eludwig17/Magic-Millipede/updated_room_diagram.pdf

# 4 feet

# 4 feet

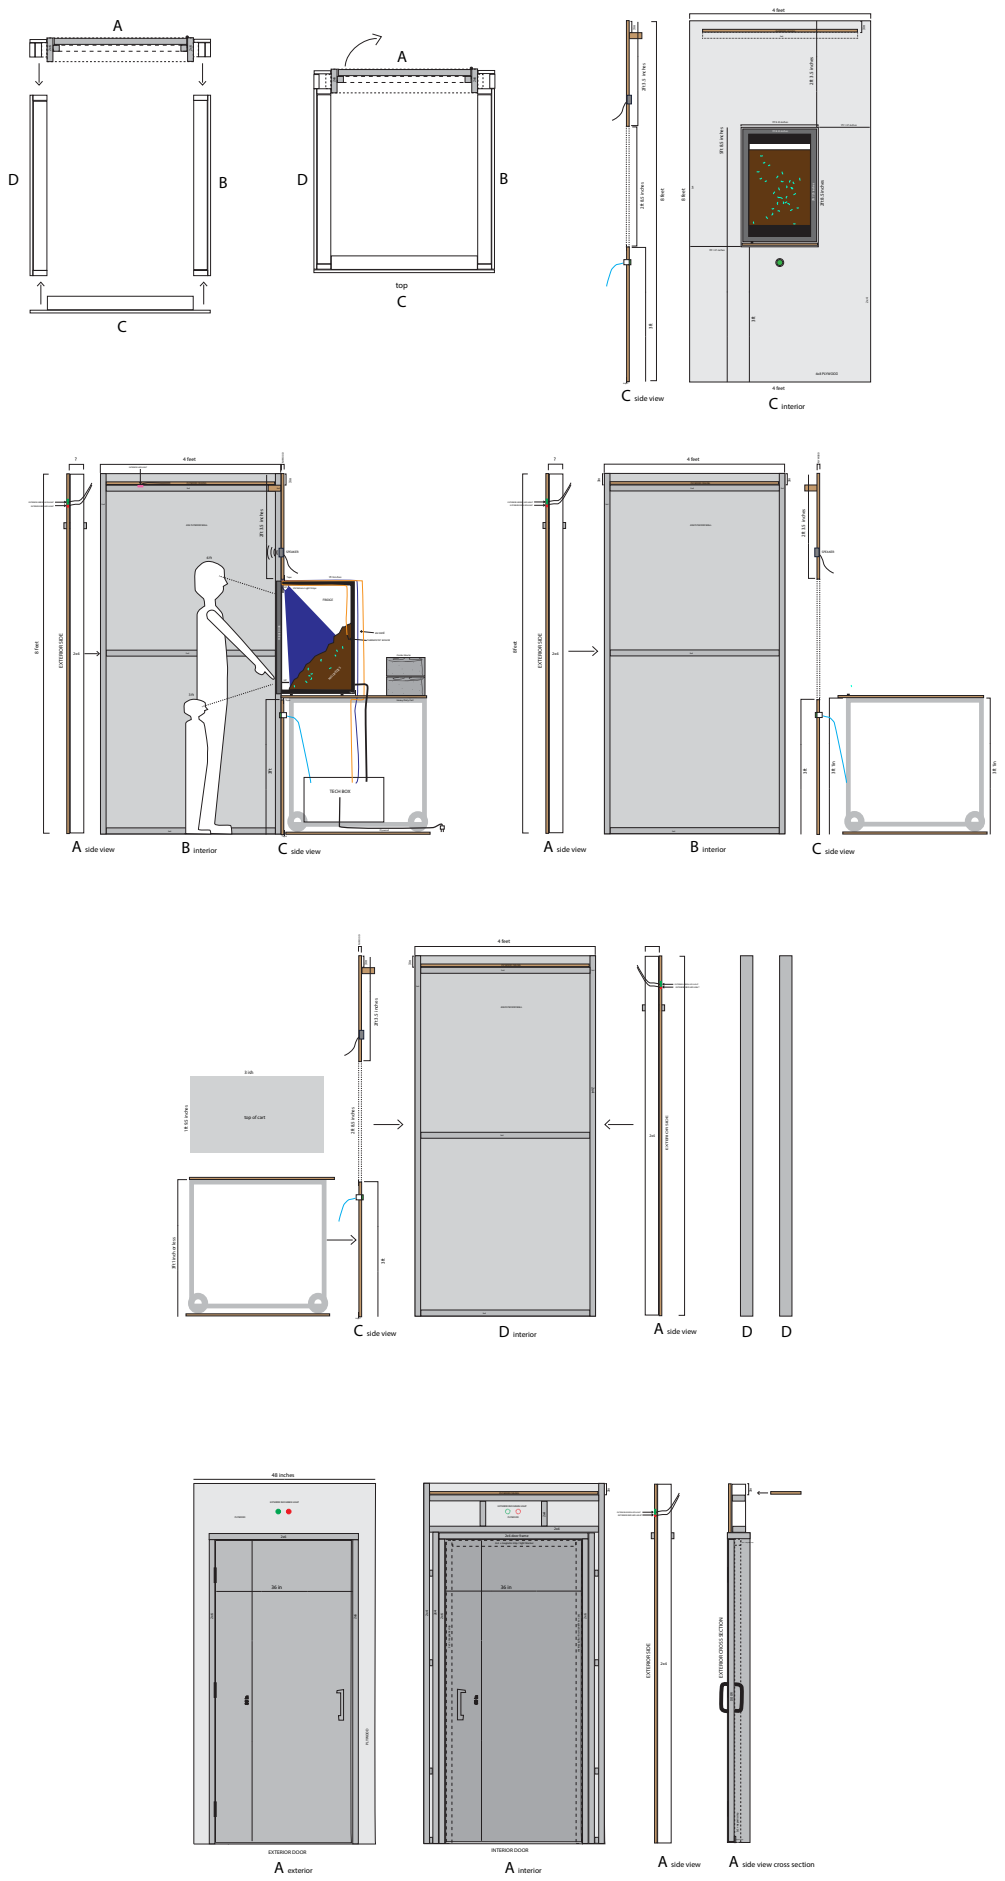
[picture p7: page 1]
EXTERIOR SIDE; TECH BOX; THERMOSTAT SENSOR; Tape; LIP; Cinder blocks; Plywood; uv cord; FRIDGE; SPEAKER; Glass Window; MILLIPEDES; 4 feet; 8 feet; 2ft 8.5 inches; 1ft 9.5 inches; 3ft 1inch or less; 3 ish; 5ft 8.5 inches; 2ft 3.5 inches; 1ft 8.25 inches; 1ft 9.25 inches; 1ft 9 inches; 1ft 1.37 inches; 2ft 7.25 inches; PLYWOOD; PLYWOOD CEILING; 4X8 PLYWOOD WALL; 4x8 PLYWOOD; FRIDGE DOOR; 2ft 3.5 inches 3ft; 48 inches; 96 inches; 2x2 + magnetic strip; 2x6 door frame; EXTERIOR DOOR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

INTERIOR LED LIGHT

EXTERIOR GREEN LED LIGHT
EXTERIOR RED LED LIGHT

UV 365nm Light Strips

Heavy Duty Cart

top of cart

EXTERIOR RED GREEN LIGHT

2x2 + magnetic strip / light blocker

EXTERIOR CROSS SECTION

light sweep ²x2 + magnetic strip
