eludwig17/Magic-Millipede/documentation/Maintenance, Care, Troubleshooting Guide.pdf

# Magic Millipedes Exhibit

## Maintenance, Care, and Troubleshooting Guide

This guide is intended to be used by museum staff who will handle operations and care in the millipede exhibit daily. This guide explains how the exhibit works, safety hazards that need to be aware of and what routine maintenance to ensure systems are running smoothly and correctly. This document requires no engineering background to follow the procedures outlined in the document; however, it’s necessary to read the safety part of this document before performing any task that will require opening up the tech box and/or accessing the UV light strip that is inside the millipede habitat.

# 1. System Overview

The millipedarium is a 16 x 12 x 8 ft enclosed structure that holds 4 identical visitor rooms that are along the back wall, with each room being fully independent of each other; each has its own habitat, electronics, and presentation system. As a result of this design, one room will not affect the other rooms

## Room Components

- A UV (365 nm) LED strip, which is mounted on the inside of the habitat, which will make the millipedes glow, which is switched on and off by a power relay module.
- A glass-fronted refrigerated habitat, which holds the live Motyxia millipedes; the fridge keeps the habitat at the optimal environment and is run on its own dedicated power circuit; the tech box has no control over the fridge.
- An interior speaker, which will play the 2-minute educational narration and music
- A red interior light, which is mounted in the top of the room; the light is always set to on to provide low-level ambient lighting, allowing visitors to see just enough of the inside of the room. The only time the interior red light is set to off is after the first 30 seconds of the narration.
- LED push button, which is mounted below the glass, which allows the visitor to start the 2-minute presentation.
- An exterior red and green indicator light, which tells other visitors outside whether or not the room is available (green light) or in use (red light)
- Tech Box, which is mounted out of the visitors' reach inside the millipedarium, where only staff can access. The small enclosure contains the microcontroller, audio sound board, amplifier, and relay module. It is powered by the 12V power supply plugged into a commercial surge protector.

## How a Visit Works

When the tech box is powered on, the exterior light above the door on the outside is green. When a visitor enters the exhibit, the visitor may faintly see the millipedes under the interior red light, and will press the button to start the presentation. Once pressed, the exterior light switches to red and will stay red for the 2-minute duration; the presentation will run through 3 phases in the code automatically.

IDLE | Awaits Button Press | Interior Red light & Exterior green Light on
PHASE 1 | 0:00-0:30 | Audio narration track 1 begins, UV light is off, interior red light is turned off at
0:30
PHASE 2 | 0:30-1:30 | UV light turns on, audio narration track 2 begins,
PHASE 3 | 1:30-2:00 | UV light turns off, audio track 3 - music plays for last 30 seconds
END | 2:00 | Code returns back to IDLE state; room is set back to default configuration & awaits next
visitor

Note: When a presentation is running, the button inputs are ignored entirely, thus ensuring pressing it repeatedly doesn’t restart, extend, or interrupt the narration cycle. This is a safety feature to ensure the millipedes won’t be over-exposed to the UV light.

# 2. Normal Operations

The procedures cover the daily routing for opening and closing the exhibit, & under normal conditions, the system is designed to run continuously and unattended for the full exhibit day. The procedure below assumes the exhibit was properly

## 2.1 Opening the Exhibit

1. Walk through the floor checking each room is still at its IDLE state before opening exhibit to public
2. Check millipede Habitats looking through the glass
3. Test each room to ensure it functions as intended
4. Open exhibit to the public

## 2.2 During the Day

- Since the exhibit is designed for unattended operation. No staff intervention is required
- If a visitor reports a problem, log which room and what they observed and then go to Troubleshooting section
- If a room is stuck, go to troubleshooting guide based off of symptoms

## 2.3 Closing the Exhibit

Visually confirm each room’s lights are at its intended IDLE state

## 2.4 Reading the Presentation Counter

Each tech box will keep running a count of how many presentation cycles it will have played through; this number persists on power loss. Engineers who have physical access to the tech box can read it through the microcontroller’s USB port using the Arduino IDE Serial Monitor. The museum staff are not expected to perform this task, as it’s documented here for completeness & for the engineering team’s reference during its scheduled maintenance visits.

# 3. Safety Warnings

It is highly critical that before opening the tech box, accessing the UV light strip, or performing any maintenance task in this guide. The hazards below are listed in the order of severity.

## Danger

UV-A Radiation | Eye & Skin Hazard
The interior UV light strip emits ultraviolet light at 365 nm; having direct exposure has the potential to cause eye irritation, visual disturbance, and skin reddening with prolonged exposure. Never stare directly at the UV strip while it is on. Do not operate the UV strip with the habitat glass removed. If inspection of the UV light is required, ensure the tech box is disconnected from power and wait at least 10 seconds before opening up the habitat, and do not attempt to bypass the power relay module or wire the UV directly to power for any reason.

AC Main Voltage Inside the Power Adapter
Since the 12 V power supply powers each tech box, which is plugged into a standard wall outlet, which has live electricity running through the system. Do not open the power adapter housing if an adapter is damaged or frayed. The fridge is also powered by AC and should only be serviced by qualified personnel

## Warning

Hot Surfaces | Audio Amplifier
The audio amplifier that is held inside of the tech box may become warm during normal operation, especially after consecutive presentations. Allow for at least 2 minutes after powering down before touching the internal components.

Live 12 V DC Inside the Tech Box
When the room is in an IDLE state, the 12V rail in the tech box is still energized as long as the power supply is plugged into the power adapter. The 12V DC isn’t lethal; however, a short circuit can produce sparks, melt wiring, and start a fire. So always unplug the 12 V adapter from the tech box before opening the tech box enclosure for any reason.

## Caution

Refrigerator & Habitats are Out of Scope of this Guide
This guide only covers the tech box, buttons, lights, speaker, and UV strip. As a result, it doesn’t cover the refrigerator and the millipedes, temperature regulation, humidity, or feeding. So do not attempt to service the fridge with this guide or by yourself without authorized personnel.

Liquid Near Electronics
Do not attempt to clean any surface inside or around the tech box using liquid sprays; use only a dry microfiber cloth. If using a spray liquid, spray directly onto a cloth and wipe with the tech box power disconnected.

# 4. Routine Maintenance

Routine maintenance is divided up into various daily, weekly, and monthly tasks; all the tasks should be performed outside of the public exhibit hours. Tasks that are specifically marked with "Engineer" will require a member of the engineering team and are listed for awareness.

## 4.1 Maintenance Schedule

Daily
- Opening & Closing Checklist | Staff
- Sanitize the push buttons | Staff
Weekly
- Confirm full 2-minute cycle of each room | Staff
Monthly
- Inspect the tech box ventilation and remove dust buildup | Staff
- Verify UV light strip illumination is uniform | Staff
Quarterly
- Read the presentation counter and log into a maintenance binder | Engineer
- Inspect all the wire terminals inside tech box for loose wiring | Engineer

## 4.2 Task Details

Sanitize push buttons | Daily
Tools: Microfiber cloth
1. Confirm room is in IDLE state
2. Spray cleaning solution on cloth
3. Wipe down push buttons
4. Confirm push button is clean and dry before leaving room
Ensure the button is clean and there are no fingerprints or smudges on the button. Also check the button clicks normally when tested.

Confirm 2-minute Cycle | Weekly
Tools: Timer
1. Press button and start timer
2. At 30 seconds, confirm uv light turns on, and interior light turns off
3. At 1 minute 30 seconds, uv light turns off and music begins
4. At end of 2 mins, confirm machine returns to idle state with green exterior light
5. Repeat across all 4 rooms
All four rooms complete the cycle within 1 second of the listed time; if a room fails, log symptom and move to Troubleshooting Page
Inspect tech box ventilation | Monthly
Tools: Flashlight & compressed air
1. Unplug the 12 V power adapter and confirm all lights are dark
2. Open the tech box and shine flashlight into the box
3. Inspect for dust build up across parts, and use compressed air to clear off dust
4. Confirm there aren’t insects, debris, or loose wiring present
5. Close tech box and plug power back to tech box; verify the room returns to idle state
All the components are visibly clean, and there are no loose wires; the room returns to the normal idle state on power up.
Verify UV strip uniformity | Monthly
Tools: None
1. Outside of habitat glass, trigger a presentation from the push button
2. When UV light turns on at the 30-second mark, glance across the strip from the side but do not stare directly at the UV light strip
3. Confirm all the segments appear equally bright & look for segments that are dimmer or dark
4. If a segment is dimmer or dark, log it for the engineering team.
Ensure the UV strip glows uniformly along the full length; the millipedes are glowing

# 5. Troubleshooting & FAQ

Each issue will be identified by a code T-##, which can be referenced with maintenance logs and logging events that occur. For each issue there will be symptoms a visitor or staff member may notice, possible underlying causes, and a step-by-step procedure to resolve it. If a procedure does not resolve the issue, escalate to the engineering team and include the issue code in the employee report.

## T-01 | Exterior Light is Dark

Symptoms: Visitor reports the door looks closed or there is no light above it. The interior of the room is also dark, and pressing the button does nothing.
Root cause: Tech box lost power
How to troubleshoot:

1. Confirm the 12 V power supply is fully seated in both the wall outlet and the tech box's barrel jack.
2. If power is confirmed at the outlet but the room remains dark, the adapter has failed. Replace it with the spare listed in the Bill of Materials
3. After power is restored, the room should return to idle (green exterior light, interior red light on) within 5 seconds.

## T-02 | Exterior Light is stuck on red

Symptoms: Exterior light stays red even when no presentation is running and no one is in the room Root cause: Microcontroller froze mid-cycle
How to troubleshoot:
1. Wait 3 minutes and listen at the door. If you hear audio, a cycle is running
2. If silent and still red, reconnect the power adapter
3. Confirm the room returns to green within 5 seconds, then run one test cycle

## T-03 | Pressing the button does nothing

Symptoms: A button press doesn’t start a presentation
Root cause: Button has failed
How to troubleshoot:
1. Wait 10 seconds and press the button firmly once. You should hear an audible click
2. If still no response, power-cycle the tech box and test again
3. If the button still doesn't work, mark the room "Out of Service" and contact engineering; the button is a listed replacement part

## T-04 | Audio is silent or distorted during presentation

Symptoms: The presentation cycle starts normally, but audio is missing, crackling, or much quieter than usual
Root cause: Loose speaker wire, overheated amplifier, or corrupted audio files
How to troubleshoot:
1. Run a test cycle from inside the room with the door closed
2. If silent, power cycle the tech box and test again
3. If distorted, power off for 10 minutes to let the amplifier cool, then re-test. Persistent distortion means the amplifier needs replacement

## T-05 | UV light does not turn on at 30-second mark

Symptoms: Audio plays and the cycle proceeds normally, but the millipedes never glow Root cause: UV relay or UV strip has failed
How to troubleshoot:
1. Power-cycle the tech box and run another test cycle

2. At the 30-second mark, listen at the tech box. A faint click means the relay fired, and the problem is downstream at the UV strip
3. No click means the relay has failed; mark the room "Out of Service" and notify engineering
T-06 | The phase cycle is too long or short.

Symptoms: Exterior light returns to green in clearly less than 2 minutes or stays red noticeably longer than 2 minutes
Root cause: Software timing issue
How to troubleshoot:
1. Time three consecutive cycles with a stopwatch
2. If all three are off by the same amount, escalate to engineering; the timing needs adjustment
3. If the length varies cycle to cycle, power cycle the tech box and re-test.

## T-07 | The interior red light is off

Symptoms: Audio and UV still work, but the room is much darker than usual at idle
Root cause: Interior light is wired separately from the tech box; the bulb or its dedicated power feed has failed
How to troubleshoot:
1. Confirm the rest of the room works normally. If so, the tech box is fine
2. Inspect the interior light fixture and its power connection. Reconnect if loose, or replace the LED light if failed
3. If you can't restore it, escalate to engineering

## Frequently Asked Questions

Q: How many presentations can the system run per day?
A: The system is designed for at least 10 hours of continuous operation every day; there isn’t a specific limit on the number of presentations. With there being a 2-minute cycle, a minute can run approximately 300 cycles per day.

Q: Can a visitor stop a presentation early?
A: No, once a cycle is started it will run to the completion; this ensures that all the timing is pre-set and doesn't change at any point

Q: Can I run more than one room at a time?
A: Yes, as each room is independent and has its own tech components that are identical, they will not affect each other

# 6. Replacement Parts | Bill of Materials

Below is a list of every replaceable component that is inside the tech box; quantities are listed per room. Ensure you have spares in storage for all the exhibits.

Component | Part
12 V DC Power Supply | Waveform Lighting PN 3091
Microcontroller | Inland ESP32 Dev Board-WROOM-32D Module
Audio Sound Board | Adafruit Audio FX 16MB (full size)
Audio Amplifier | TPA3116D3 2x50W
DC-DC Buck Converter | LM2596 (12V to 5V)
Relay Module | AEDIKO 4-channel 12V low trigger relay (NO config)
UV LED Strip | Waveform RealUV 365 nm (PN 7021.65)
Push Button | Baomain 19mm Stainless Momentary (12-24V)
Exterior & Interior Indicator Light | Baomain 19mm strainless RGB indicator 12-24V
DC Barrel Jack (5.5 x 2.1mm) | CENTROPOWER
Perfboard | 7 x 9 cm Perfboard (Smraza kit)
Female Pin Headers | 2.54 mm pitch (Smraza kit)
Screw Terminal Blocks | 2-pin / 3-pin 5mm pitch (Smraza kit)
