eludwig17/Magic-Millipede/(commit log)

2026-04-15 adding microcontroller file to repository, removed audio logic since switching to FX board directly to new 2x50W amp
2026-04-15 Update README with perf board layout
    Added performance board layout images to README.
2026-04-16 included button pinout for the interior red LED, separated names between exterior & interior
2026-04-16 added state machine logic for the 2 minute narration sequence, still need to finish finalized code logic with sound board
2026-04-21 testing uv-relay switch, and new 12V led button wiring
2026-04-23 esp32 dev board taking place of raspi pico after electrical incident, same code logic but turning off wifi/BT features of esp32
2026-04-23 added exhibit counter functions that were missing
    [millipede-esp32.ino]
2026-04-24 forgot to add back interior red led logic back into new file, also for some reason logic is reversed on 3rd relay module in comparison to other relays, if logic is different on relay module, reverse 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
    [millipede-esp32.ino]
2026-04-24 referred back to SRD and had interior light relay logic too late in sequence
2026-04-24 adding an audio track w/ license file & updated ignore file
2026-04-27 added presentation counter reader in the serial monitor/output in arduino ide
2026-04-29 working implementation of the audio sequence on the esp32 & soundboard -- IMPORTANT: T03 audio file is T01 but renamed, pin configuration was set from T01 to T03 in debugging, but should be T01 in fi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
2026-04-30 removed markdown file for maintenance and will upload a documentation in pdf & for microcontroller added a debounce for the button press
2026-04-30 added finalized wiring diagram for the tech box
